ToolKnox/Quadruped-II/BOM.pdf

B I L L O F M A T E R I A L S

# Quadruped II

Rev. 2026-04-30 96 items

View this project on Printables (https://www.printables.com/model/1451339-quadruped-ii) | Buy me a Beer (https://www.paypal.com/paypalme/TomKnox3d) | Join my club for exclusive models (https://www.printables.com/@TomKnox_1573)

BOM | Product/Project: Quadruped II
Revision date: 2026-04-30 | https://www.printables.com/model/1451339-quadruped-ii
ELECTRICAL COMPONENTS | 22 items
Description | Qty | AliExpress | Amazon (Geniuslink) | Notes

>>

0001-1202 Power_Dist-PCB | 1

SPECIAL CTA

Order PCB HERE (https://www.pcbway.com/project/shareproject/Quadruped_PCB_v1_0_3a5d3450.html)

Power Distrivbution PCB - PCB Files availible for Clubmembers

>>

Servo Motors | x12 | AliExpress Link (https://s.click.aliexpress.com/e/_c3oYCwzH) | Amazon Link (https://geni.us/niJrcJn)

180 degrees, 35kg (Approx
49.5x20,2x40mm)

->

ALT | Servo Motors | x12 | AliExpress Link (https://s.click.aliexpress.com/e/_c355UoGD) | Amazon Link (https://geni.us/RV1IBB) | Budget friendly alternative.

->

ALT | Servo Motors | x12 | AliExpress Link (https://s.click.aliexpress.com/e/_c4nKdy0D) | Amazon Link (https://geni.us/aHJvHX3) | Budget friendly alternative.
>> | Raspberry Pi 4 Model B | 1 | AliExpress Link (https://s.click.aliexpress.com/e/_c3vHe6u7) | Amazon Link (https://geni.us/j51XYY) | 8gb Ram

>>

LiPo Battery | 1 | AliExpress Link (https://s.click.aliexpress.com/e/_c3RFa1Cf) | Amazon Link (https://geni.us/4H2lJ)

4000mAh 4S 45~90C Lipo Pack w/XT-90

>> | IMU | 1 | AliExpress Link (https://s.click.aliexpress.com/e/_c3RY5ql9) | Amazon Link (https://geni.us/GV5tKTw) | Integrated Measuring Unit
>> | Raspberry Pi Breakout Board | 1 | AliExpress Link (https://s.click.aliexpress.com/e/_c3qH7iyL) | Amazon Link (https://geni.us/MbTbrQP) | Made by Dfrobot
>> | Fan | x2 | AliExpress Link (https://s.click.aliexpress.com/e/_c2yKau2J) | Amazon Link (https://geni.us/bTXZ0) | 60x60 12v
>> | Servo Driver PCA9685 | 1 | AliExpress Link (https://s.click.aliexpress.com/e/_c4WSVNR5) | Amazon Link (https://geni.us/AAHBTxq) | Communication via I2C interface

>>

Arduino Nano | 1 | AliExpress Link (https://s.click.aliexpress.com/e/_c4lOubMf) | Amazon Link (https://geni.us/aKQfQgw)

For IMU, Battery sensing, LCD screen

>> | DC to DC (Buck) converter 20A | 1 | AliExpress Link (https://s.click.aliexpress.com/e/_c4a1nZOH) | Amazon Link (https://geni.us/TxDhP) | Adjustable, set to ~7V
>> | DC to DC (buck) converter 3A | 1 | AliExpress Link (https://s.click.aliexpress.com/e/_c3nZjuCN) | Amazon Link (https://geni.us/S4EAS28) | For fans
>> | 32GB MicroSD card | 1 | AliExpress Link (https://s.click.aliexpress.com/e/_c4Vsk2D9) | Amazon Link (https://geni.us/dKVzS49) | 32GB is maximum Pi supports
>> | RasbPi Cooling System | 1 | AliExpress Link (https://s.click.aliexpress.com/e/_c4VTyh0n) | Amazon Link (https://geni.us/PANnd) | -
>> | Arduino Nano Breakout Board | 1 | AliExpress Link (https://s.click.aliexpress.com/e/_c4dG8Y8L) | Amazon Link (https://geni.us/PcfeRm2) | -

BOM | Product/Project: Quadruped II
Revision date: 2026-04-30 | https://www.printables.com/model/1451339-quadruped-ii

### ELECTRICAL COMPONENTS continued

Description | Qty | AliExpress | Amazon (Geniuslink) | Notes

>>

GPIO Cable | 1 | AliExpress Link (https://s.click.aliexpress.com/e/_c4avRRfl) | Amazon Link (https://geni.us/EjrSRtX) | To connect Pi to its breakout board

>>

| Logic Level Converter | 1 | AliExpress Link (https://s.click.aliexpress.com/e/_c2wzgmJt) | Amazon Link (https://geni.us/3TiJfB) | For adjusting voltage between the pi and the nano
>> | XT60H Connector | 1 | AliExpress Link (https://s.click.aliexpress.com/e/_c3piOj51) | Amazon Link (https://geni.us/aVZdcGf) | To connect LiPo to the robot
>> | LCD Screen | 1 | AliExpress Link (https://s.click.aliexpress.com/e/_c4pjNsUD) | Amazon Link (https://geni.us/CAwIn) | 1.47 inch
>> | PS4 Controller | 1 | AliExpress Link (https://s.click.aliexpress.com/e/_c4CvwWxp) | Amazon Link (https://geni.us/XiW4) | -
>> | Digital Voltmeter | 1 | AliExpress Link (https://s.click.aliexpress.com/e/_c3UuRXlD) | Amazon Link (https://geni.us/mbArXwk) | DC 2.5-30V, used to measure battery voltage

BOM | Product/Project: Quadruped II
Revision date: 2026-04-30 | https://www.printables.com/model/1451339-quadruped-ii
MECHANICAL COMPONENTS | 28 items
| Description | Qty | AliExpress | Amazon (Geniuslink) | Notes
>> | Bearing | x4 | AliExpress Link (https://s.click.aliexpress.com/e/_c4qqMrGR) | Amazon Link (https://geni.us/AmOzp) | 6705-2RS 25X32X4
>> | Thrust Bearings | x4 | AliExpress Link (https://s.click.aliexpress.com/e/_c4LuEC4L) | Amazon Link (https://geni.us/sMGxk4) | F4-10M 4x10x4mm
>> | Bearing | x20 | AliExpress Link (https://s.click.aliexpress.com/e/_c4lVCOIX) | Amazon Link (https://geni.us/zvnXU) | 684ZZ Mini Deep Groove Ball Bearing 4x9x4mm
>> | Servo horns | x4 | AliExpress Link (https://s.click.aliexpress.com/e/_c3qWmlYf) | Amazon Link (https://geni.us/KN5c9Mg) | RC Car Steering Servo Horn Arm 25T Teeth Long
>> | Heatsinks | x12 | AliExpress Link (https://s.click.aliexpress.com/e/_c3aKP3CR) | Amazon Link (https://geni.us/lxJBOw) | 6mm, black. Cut in half for each servo
>> | Servo Discs | x10 | AliExpress Link (https://s.click.aliexpress.com/e/_c3ajtifh) | Amazon Link (https://geni.us/ZDgXW) | with screws.
>> | Threaded rods - Long | x4 | AliExpress Link (https://s.click.aliexpress.com/e/_c4UsQtab) | Amazon Link (https://geni.us/M8sIZIp) | M3 x 110mm (cut to length if needed)
>> | Threaded rods - Short | x4 | AliExpress Link (https://s.click.aliexpress.com/e/_c4ohc7TN) | Amazon Link (https://geni.us/IXWZiC0) | M3 x 25mm (cut to length if needed)
>> | Magnets | x8 | AliExpress Link (https://s.click.aliexpress.com/e/_c4PVNdwL) | Amazon Link (https://geni.us/OPu9pBg) | Used to hold fans in place
>> | Ballt Joint (Long joint) | x8 | AliExpress Link (https://s.click.aliexpress.com/e/_c4BWGoqR) | Amazon Link (https://geni.us/DR5Z7v) | S - 3mm L30mm M3
>> | Ball Join (Short Joint) | x8 | AliExpress Link (https://s.click.aliexpress.com/e/_c4BWGoqR) | Amazon Link (https://geni.us/BkDvnH) | N - 3mm L20mm M3
>> | On/off Switch | 1 | AliExpress Link (https://s.click.aliexpress.com/e/_c2x5Xvx9) | Amazon Link (https://geni.us/dgsSxN) | 20A at 14VDC rated
>> | Spring | 1 | AliExpress Link (https://s.click.aliexpress.com/e/_c38DYmvz) | Amazon Link (https://geni.us/t9JlB) | For battery latch mechanism. 35mm long x 7mm OD
>> | Smooth Rod 3x80 | 1 | AliExpress Link (https://s.click.aliexpress.com/e/_c3QIiv61) | Amazon Link (https://geni.us/6dBY98) | For battery hinge mechanism 3x75-80mm (cut to length if needed)
>> | Misc | 1 | - | - | -

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

### MECHANICAL COMPONENTS continued

| Description | Qty | AliExpress | Amazon (Geniuslink) | Notes
>> | Male Connector (for peripherals) | x12 | AliExpress Link (https://s.click.aliexpress.com/e/_c3eOJxcB) | Amazon Link (https://geni.us/g3jfpk7) | B2B-PH-K-S(LF)(SN)
>> | Socket for Connectors | x25 | AliExpress Link (https://s.click.aliexpress.com/e/_c4XMd4bp) | Amazon Link (https://geni.us/FWRkK) | SPH-002T-P0.5S
>> | Female Connector (for peripherals) | x12 | AliExpress Link (https://s.click.aliexpress.com/e/_c3AkcVdD) | Amazon Link (https://geni.us/Auyl1wR) | PHR-2
>> | Capacitor | 1 | AliExpress Link (https://s.click.aliexpress.com/e/_c4N6hXdZ) | Amazon Link (https://geni.us/Hxr7KrE) | 2200uF 16VDC Electrolytic RB Capacitor ,For servo board
>> | Reverse Polarity Protection Diode | 1 | AliExpress Link (https://s.click.aliexpress.com/e/_c3GnIKbp) | Amazon Link (https://geni.us/2JNVK) | B160-13-F
>> | Ferrules | 1 | AliExpress Link (https://s.click.aliexpress.com/e/_c4b0JD7N) | Amazon Link (https://geni.us/uW3lDP) | Optional, if used need approx 20 across robot
>> | Terminal Blocks | x8 | AliExpress Link (https://s.click.aliexpress.com/e/_c4pZ8KUj) | Amazon Link (https://geni.us/jVKo7C) | 1935776
>> | 100k resistors | 1 | AliExpress Link (https://s.click.aliexpress.com/e/_c3fDqW83) | Amazon Link (https://geni.us/CDzFOW) | For dividing the voltage at the buck converter so that it is readable by the nano
>> | 47k Resistor | 1 | AliExpress Link (https://s.click.aliexpress.com/e/_c4c1Cx8n) | Amazon Link (https://geni.us/wGvVe) | CRGCQ1206F47K
>> | 10k resistor | 1 | AliExpress Link (https://s.click.aliexpress.com/e/_c4c1Cx8n) | Amazon Link (https://geni.us/aShan4) | CRGCQ0805F10K
>> | Heat Shrink | 1 | AliExpress Link (https://s.click.aliexpress.com/e/_c30Kx0Xt) | Amazon Link (https://geni.us/QeW8) | Only small amount required, for covering exposed solid-core wires
>> | Power Delivery Wire | 1 | AliExpress Link (https://s.click.aliexpress.com/e/_c3XeHXW7) | Amazon Link (https://geni.us/XebB) | Minimum 12AWG, for wires expected to carry current above 2A and/or voltage above 5V
>> | Connection Wire | 1 | AliExpress Link (https://s.click.aliexpress.com/e/_c3XeHXW7) | Amazon Link (https://geni.us/BbErE) | 19-30AWG, recommend solid core, used for all other wires

BOM | Product/Project: Quadruped II
Revision date: 2026-04-30 | https://www.printables.com/model/1451339-quadruped-ii
FASTENERS | 22 items
| Description | Qty | AliExpress | Amazon (Geniuslink) | Notes
>> | MC6S-M2x8 | x8 | AliExpress Link (https://s.click.aliexpress.com/e/_c4bQkDH7) | Amazon Link (https://geni.us/rs8P) | M2 - Socket Head Cap Screw
>> | M6CS-M2x4 | x14 | AliExpress Link (https://s.click.aliexpress.com/e/_c4bQkDH7) | Amazon Link (https://geni.us/rs8P) | M2 - Socket Head Cap Screw
>> | MC6S-M2.5x6 | x8 | AliExpress Link (https://s.click.aliexpress.com/e/_c4bQkDH7) | Amazon Link (https://geni.us/Dwz2G) | M2.5 - Socket Head Cap Screw
>> | MC6S-M3x8H | x38 | AliExpress Link (https://s.click.aliexpress.com/e/_c4bQkDH7) | Amazon Link (https://geni.us/opo4e) | M3 - Socket Head Cap Screw
>> | MC6S-M3x10H | x4 | AliExpress Link (https://s.click.aliexpress.com/e/_c4bQkDH7) | Amazon Link (https://geni.us/BrqdjZP) | M3 - Socket Head Cap Screw
>> | MC6S-M3x14H | x6 | AliExpress Link (https://s.click.aliexpress.com/e/_c4bQkDH7) | Amazon Link (https://geni.us/pltePAU) | M3 - Socket Head Cap Screw
>> | MC6S-M3x20H | x16 | AliExpress Link (https://s.click.aliexpress.com/e/_c4bQkDH7) | Amazon Link (https://geni.us/9za99) | M3 - Socket Head Cap Screw
>> | MC6S-M3x25 | x4 | AliExpress Link (https://s.click.aliexpress.com/e/_c4bQkDH7) | Amazon Link (https://geni.us/W5BJX) | M3 - Socket Head Cap Screw
>> | MC6S-M4x25H | x4 | AliExpress Link (https://s.click.aliexpress.com/e/_c4bQkDH7) | Amazon Link (https://geni.us/rjvj) | M4 - Socket Head Cap Screw
>> | MC6S-M4x16H | x4 | AliExpress Link (https://s.click.aliexpress.com/e/_c4bQkDH7) | Amazon Link (https://geni.us/wGOaQNE) | M4 - Socket Head Cap Screw
>> | MF6S-M3x8 | x52 | AliExpress Link (https://s.click.aliexpress.com/e/_c3LeLqlR) | Amazon Link (https://geni.us/5EC13) | M3 - Countersunk Socket Head Cap Screw
>> | K6S - M3x8 | x4 | AliExpress Link (https://s.click.aliexpress.com/e/_c3uHOBwN) | Amazon Link (https://geni.us/Ggr2) | M3 - Socket Button Head Screw
>> | K6S - M3x10 | x10 | AliExpress Link (https://s.click.aliexpress.com/e/_c3uHOBwN) | Amazon Link (https://geni.us/Tn9Jbag) | M3 - Socket Button Head Screw
>> | K6S - M3x16 | x36 | AliExpress Link (https://s.click.aliexpress.com/e/_c3uHOBwN) | Amazon Link (https://geni.us/NH5M) | M3 - Socket Button Head Screw
>> | K6S - M3x20 | x20 | AliExpress Link (https://s.click.aliexpress.com/e/_c3uHOBwN) | Amazon Link (https://geni.us/h6GNo) | M3 - Socket Button Head Screw
>> | RBS M3 (3,2x9x0,8)) | x4 | AliExpress Link (https://s.click.aliexpress.com/e/_c3ctsHrn) | Amazon Link (https://geni.us/OP2NLH7) | M3 Washer with Large O.D
>> | LM6M_A4-70(M3) | x24 | AliExpress Link (https://s.click.aliexpress.com/e/_c3CqMkJb) | Amazon Link (https://geni.us/igAkxP) | M3 Lock Nut
>> | ML6M M3 Nut | x8 | AliExpress Link (https://s.click.aliexpress.com/e/_c2wZar4p) | Amazon Link (https://geni.us/jg3ct) | M3 Nut - Low profile

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

### FASTENERS continued

| Description | Qty | AliExpress | Amazon (Geniuslink) | Notes
>> | Heat insert M3 3x5 | x96 | AliExpress Link (https://s.click.aliexpress.com/e/_c3VnredP) | Amazon Link (https://geni.us/5CT5Hf) | L=3 O.D=5
>> | Heat Insert M2 3x3 | x18 | AliExpress Link (https://s.click.aliexpress.com/e/_c3VnredP) | Amazon Link (https://geni.us/odta) | L=3 O.D=3
>> | Heat Insert M2.5 3x3.5 | x8 | AliExpress Link (https://s.click.aliexpress.com/e/_c3VnredP) | Amazon Link (https://geni.us/AATZv) | L=3 O.D=3
>> | Heat Insert M4 4x6 | x8 | AliExpress Link (https://s.click.aliexpress.com/e/_c3VnredP) | Amazon Link (https://geni.us/Naao9e) | L=4 O.D=6

BOM | Product/Project: Quadruped II
Revision date: 2026-04-30 | https://www.printables.com/model/1451339-quadruped-ii
ASSORTMENT BOXES | 7 items
| Description | Qty | AliExpress | Amazon (Geniuslink) | Notes
>> | Socket Button Head Screw | 1 | AliExpress Link (https://s.click.aliexpress.com/e/_c3s2tYkH) | Amazon Link (https://geni.us/V4MKIHK) | M2-M3 x 2510pcs
>> | Socket head cap Screw | 1 | AliExpress Link (https://s.click.aliexpress.com/e/_c4CtzBjJ) | Amazon Link (https://geni.us/cEH1f) | 2500pcs M2M2.5M3
>> | Socket head cap Screw | 1 | AliExpress Link (https://s.click.aliexpress.com/e/_c4CtzBjJ) | Amazon Link (https://geni.us/XJ9Pwm) | 1410pcs M3M4M5
>> | Countersunk Socket Head Cap Screw | 1 | AliExpress Link (https://s.click.aliexpress.com/e/_c4dPOZ2H) | Amazon Link (https://geni.us/cZwP7Io) | 3045pcs - M2, M3, M4, M5, M6, M8
>> | Heat Insert (with press) | 1 | AliExpress Link (https://s.click.aliexpress.com/e/_c4VcldtL) | Amazon Link (https://geni.us/pHv01s) | 1040pcs - M2-M4
>> | Heat Inserts | 1 | AliExpress Link (https://s.click.aliexpress.com/e/_c3cIZWyz) | Amazon Link (https://geni.us/yffvAR) | 1400pcs - M2-M4
>> | Lock Nut | 1 | AliExpress Link (https://s.click.aliexpress.com/e/_c2xGmpNx) | Amazon Link (https://geni.us/ZU2w) | 230pcs M3,M4,M5,M6,M8

BOM | Product/Project: Quadruped II
Revision date: 2026-04-30 | https://www.printables.com/model/1451339-quadruped-ii
FILAMENT | 4 items
| Description | Qty | AliExpress | Amazon (Geniuslink) | Notes
>> | PC / ASA / ABS / PETG Filament | 1 | AliExpress Link (https://s.click.aliexpress.com/e/_c3TLvFW9) | Amazon Link (https://geni.us/enf7pY) | -
>> | PC-CF / PETG-CF / PA-CF / ABS+ (Engineering Grade
| Filaments) | 1 | AliExpress Link (https://s.click.aliexpress.com/e/_c3sc5Ef3) | Amazon Link (https://geni.us/khjmN) | -
>> | PLA | 1 | AliExpress Link (https://s.click.aliexpress.com/e/_c3lakGcl) | Amazon Link (https://geni.us/pBQCzkI) | -
>> | TPU | 1 | AliExpress Link (https://s.click.aliexpress.com/e/_c4mEXgLb) | Amazon Link (https://geni.us/NGlAPc) | -

BOM | Product/Project: Quadruped II
Revision date: 2026-04-30 | https://www.printables.com/model/1451339-quadruped-ii
TOOLS | 13 items
Description | Qty | AliExpress | Amazon (Geniuslink) | Notes
>> | Soldering Iron TS101 | 1 | AliExpress Link (https://s.click.aliexpress.com/e/_c2QmV6QP) | Amazon Link (https://geni.us/rPNNHLD) | (Recommended)
>> | Heat Inset Tip Kit - For TS101 | 1 | AliExpress Link (https://s.click.aliexpress.com/e/_c4oAQMU5) | Amazon Link (https://geni.us/hrT4m82) | (Recommended)
>> | Electric Precision Screwdriver | 1 | AliExpress Link (https://s.click.aliexpress.com/e/_c4WbOjBf) | Amazon Link (https://geni.us/ckKSnm) | (Recommended)
>> | Allen Key Set | 1 | AliExpress Link (https://s.click.aliexpress.com/e/_c4dcwKsN) | Amazon Link (https://geni.us/DTXl) | (Recommended)
>> | Torx Key Set | 1 | AliExpress Link (https://s.click.aliexpress.com/e/_c3zbLorL) | Amazon Link (https://geni.us/35Em2C) | (Recommended)
>> | Torque Screwdriver | 1 | AliExpress Link (https://s.click.aliexpress.com/e/_c39Zxrt7) | Amazon Link (https://geni.us/ckKSnm) | (Recommended)
>> | Wire stripper | 1 | AliExpress Link (https://s.click.aliexpress.com/e/_c3fd1zBB?SearchText=Wire+stripper) | Amazon Link (https://geni.us/SvNtLpP) | (Recommended)
>> | Wire cutter | 1 | AliExpress Link (https://s.click.aliexpress.com/e/_c2yogYf1) | Amazon Link (https://geni.us/TFzOR4) | (Recommended)
>> | Heat Insert Press Tool | 1 | AliExpress Link (https://s.click.aliexpress.com/e/_c3ljOLkX) | Amazon Link (https://geni.us/g0yu0) | (Recommended)
>> | Crimp Tool | 1 | AliExpress Link (https://s.click.aliexpress.com/e/_c4VtpJeL) | Amazon Link (https://geni.us/RH6Ac9) | (Recommended)

->

ALT | Soldering Iron - Generic | 1 | AliExpress Link (https://s.click.aliexpress.com/e/_c4sOxkox) | Amazon Link (https://geni.us/Drzhe7o) | Budget friendly alternative

->

ALT | Heat insert tip - set | 1 | AliExpress Link (https://s.click.aliexpress.com/e/_c4V88eu7) | Amazon Link (https://geni.us/aAqQH) | Budget friendly alternative
>> | Precision Screwdriver Set | 1 | AliExpress Link (https://s.click.aliexpress.com/e/_c3bHpwH9) | Amazon Link (https://geni.us/Kk4tgSV) | Budget friendly alternative
