ToolKnox/Quadruped-II/Quadruped_ws/src/Quadruped_description/meshes/R2_obj.obj

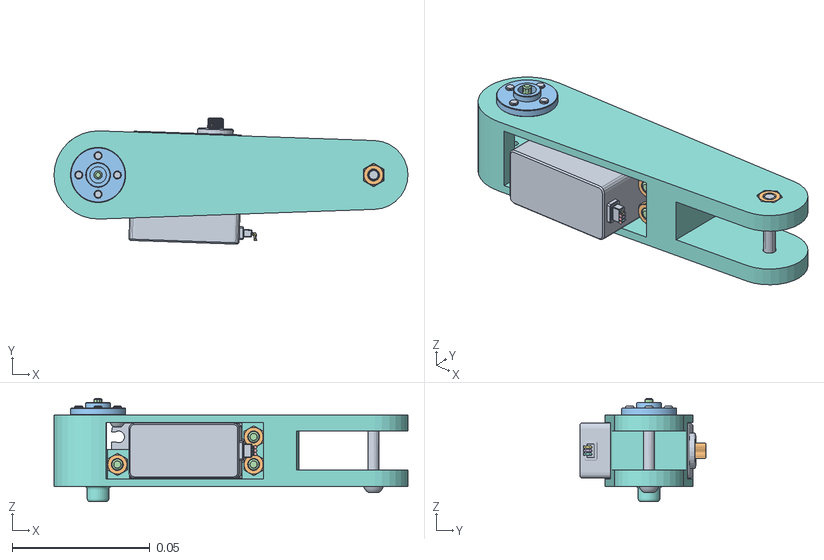
[picture p2: CAD file, 2026-04-30]
Quadruped_ws/src/Quadruped_description/meshes/R2_obj.obj
0.129 x 0.0459 x 0.0375
mesh 1 R2 joint-1/CLS6336HV-1
mesh 2 Boss-Extrude5
mesh 3 Boss-Extrude4
mesh 4 Boss-Extrude7
mesh 5 Boss-Extrude1
mesh 6 Boss-Extrude2
mesh 7 Cut-Extrude1
mesh 8 Boss-Extrude3
mesh 9 Sweep1 face
mesh 10 Fillet1
mesh 11 Fillet2
mesh 12 Chamfer1
