ToolKnox/Quadruped-II/Quadruped_ws/src/Quadruped_description/meshes/RL_link3.STL

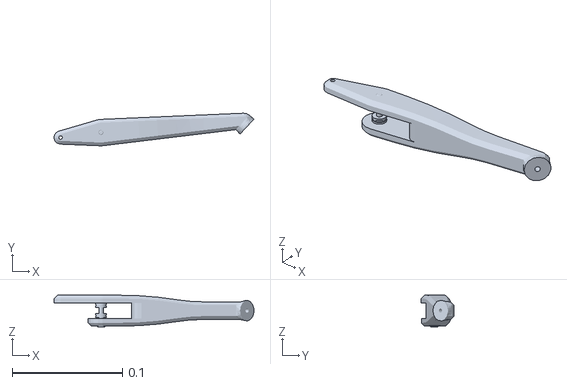
[picture p3: CAD file, 2026-04-30]
Quadruped_ws/src/Quadruped_description/meshes/RL_link3.STL
0.181 x 0.0296 x 0.029
