ToolKnox/Quadruped-II/Quadruped_ws/src/Quadruped_description/meshes/FR_link4.STL

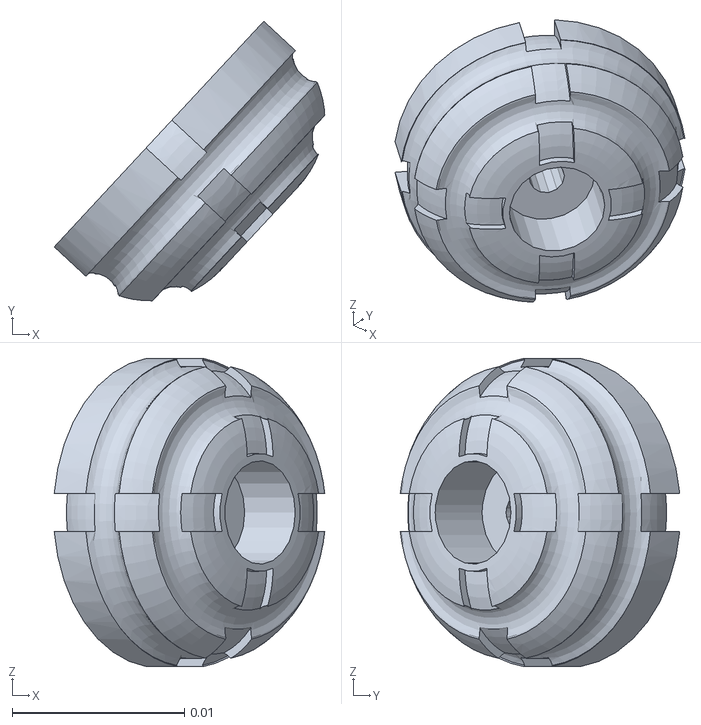
[picture p4: CAD file, 2026-04-30]
Quadruped_ws/src/Quadruped_description/meshes/FR_link4.STL
0.0157 x 0.0162 x 0.0179
