ToolKnox/Quadruped-II/Quadruped_ws/src/Quadruped_description/meshes/R_link2_collision.STL

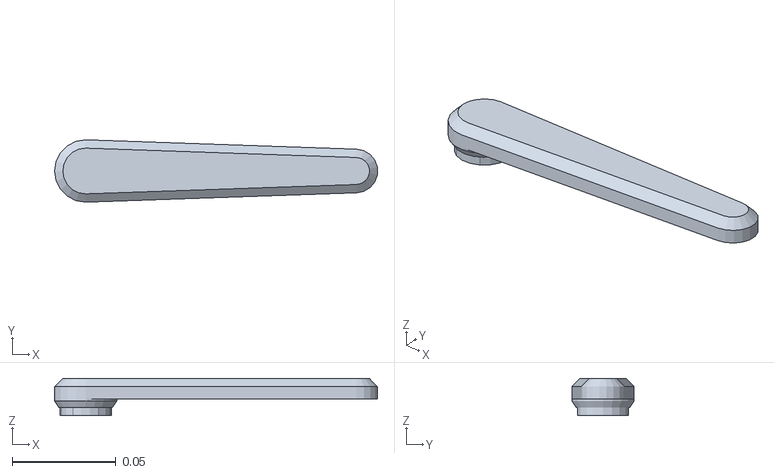
[picture p5: CAD file, 2026-04-30]
Quadruped_ws/src/Quadruped_description/meshes/R_link2_collision.STL
0.155 x 0.03 x 0.018
