ToolKnox/Quadruped-II/Quadruped_ws/src/Quadruped_description/meshes/FL_link2.STL

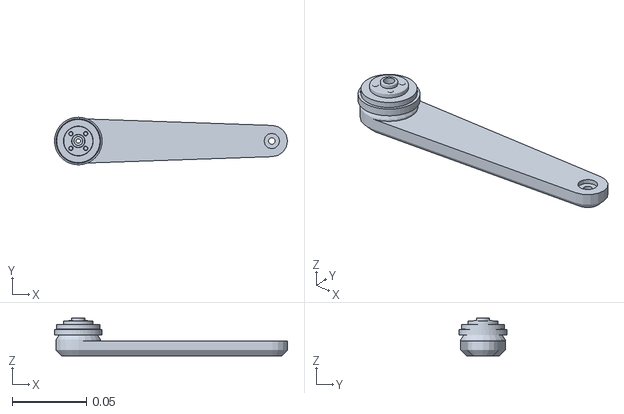
[picture p6: CAD file, 2026-04-30]
Quadruped_ws/src/Quadruped_description/meshes/FL_link2.STL
0.156 x 0.032 x 0.0255
