ToolKnox/Quadruped-II/Quadruped_ws/src/Quadruped_description/meshes/RR1_obj.obj

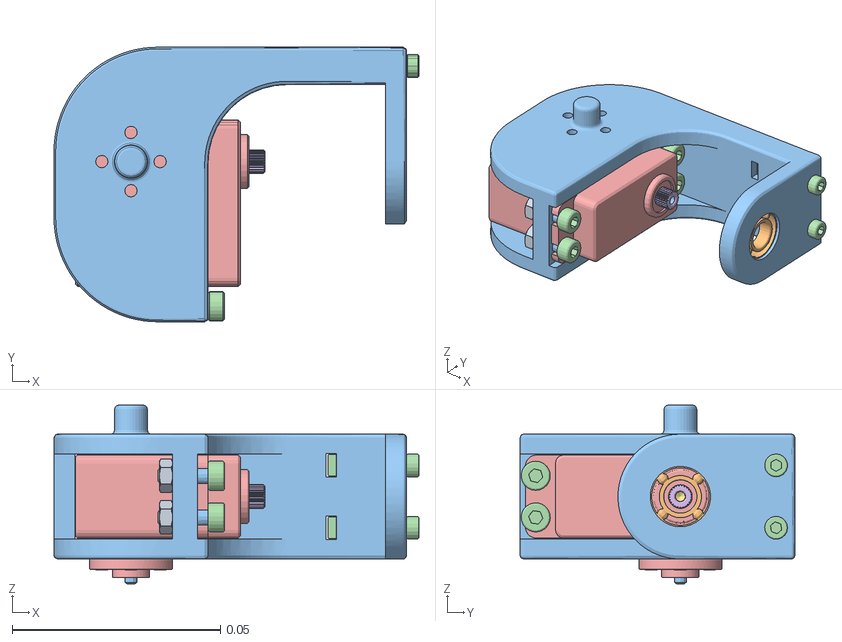
[picture p7: CAD file, 2026-04-30]
Quadruped_ws/src/Quadruped_description/meshes/RR1_obj.obj
0.0877 x 0.066 x 0.043
mesh 1 RR1 joint-1/M4 Nut DIN 934-2
mesh 2 RR1 joint-1/M4 Nut DIN 934-6
mesh 3 RR1 joint-1/688 CN-1/bearing_688_1_01-1
mesh 4 RR1 joint-1/688 CN-1/bearing_688_1_02-1
mesh 5 RR1 joint-1/688 CN-1/bearing_688_1_03-1
mesh 6 RR1 joint-1/M4 Nut DIN 934-1
mesh 7 RR1 joint-1/M3 x 6 DIN 912-1
mesh 8 Chamfer1 face
mesh 9 RR1 joint-1/CLS6336HV-1
mesh 10 Boss-Extrude5
mesh 11 Boss-Extrude4
mesh 12 Boss-Extrude7
mesh 13 Boss-Extrude1
mesh 14 Boss-Extrude2
