ToolKnox/Quadruped-II/Quadruped_ws/src/Quadruped_description/meshes/RR_link1.STL

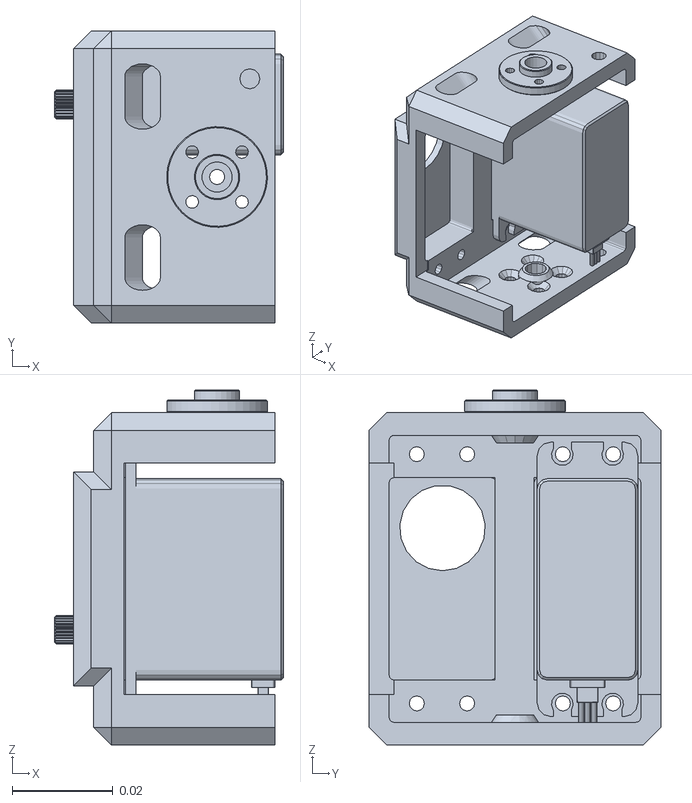
[picture p8: CAD file, 2026-04-30]
Quadruped_ws/src/Quadruped_description/meshes/RR_link1.STL
0.0455 x 0.058 x 0.0705
