ToolKnox/Quadruped-II/Quadruped_ws/src/Quadruped_description/meshes/hokuyo_ust10.stl

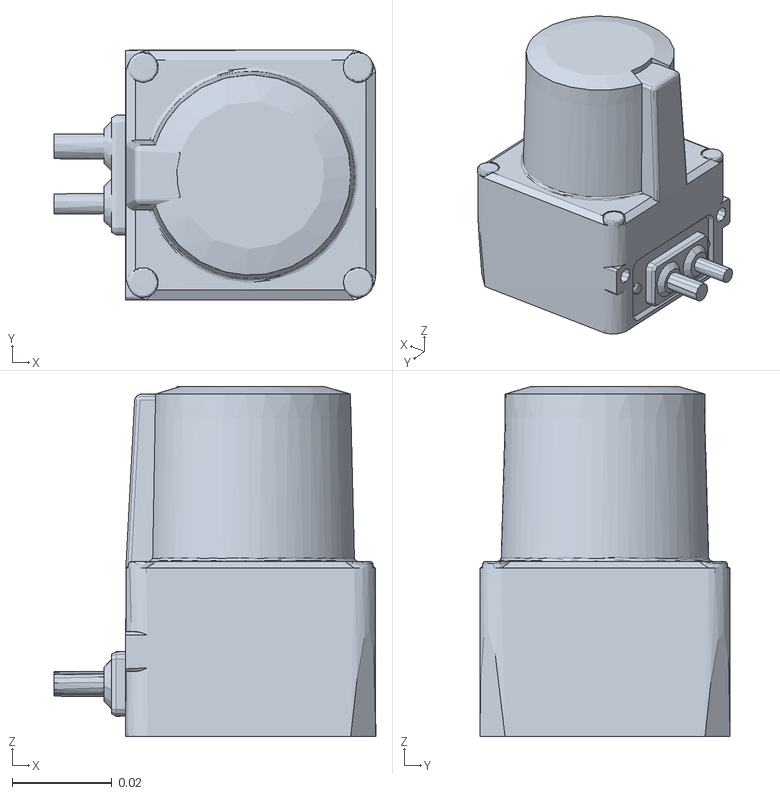
[picture p9: CAD file, 2026-04-30]
Quadruped_ws/src/Quadruped_description/meshes/hokuyo_ust10.stl
0.0643 x 0.05 x 0.07
