ToolKnox/Quadruped-II/Quadruped_ws/src/Quadruped_description/meshes/R3_obj.obj

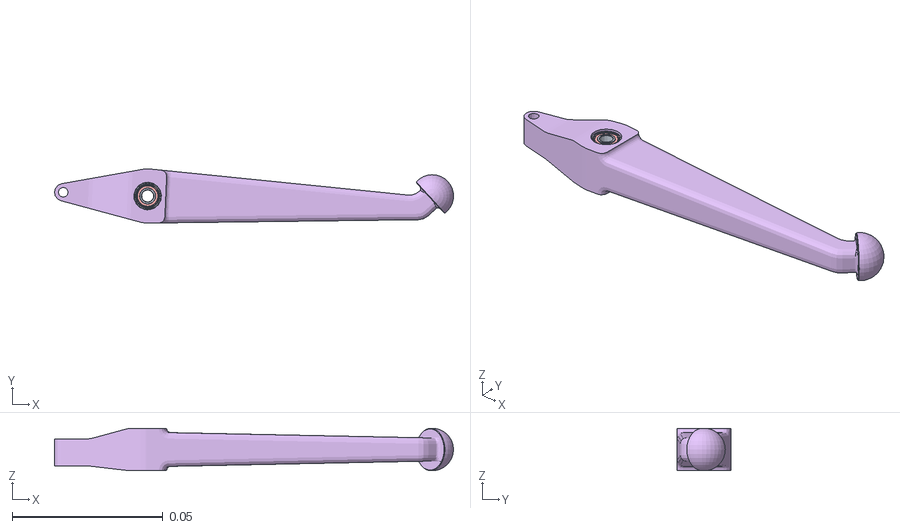
[picture p10: CAD file, 2026-04-30]
Quadruped_ws/src/Quadruped_description/meshes/R3_obj.obj
0.132 x 0.018 x 0.014
mesh 1 R 3 joint-1/684 2Z CN-1
mesh 2 Imported_11-1-solid1 face
mesh 3 Imported_11-1-solid1
mesh 4 Imported_9-1-solid1 face
mesh 5 Imported_1-1-solid1 face
mesh 6 Imported_4-1-solid1 face
