ToolKnox/Quadruped-II/Quadruped_ws/src/Quadruped_description/meshes/base_collision.STL

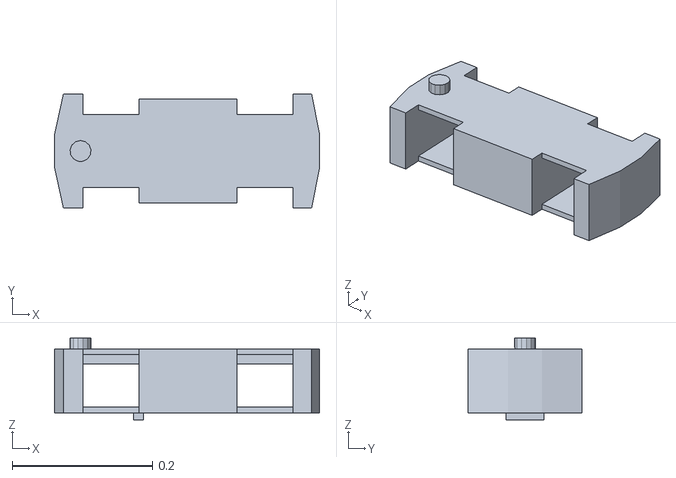
[picture p11: CAD file, 2026-04-30]
Quadruped_ws/src/Quadruped_description/meshes/base_collision.STL
0.378 x 0.162 x 0.117
