ToolKnox/Quadruped-II/Quadruped_ws/src/Quadruped_description/meshes/L_link1_collision.STL

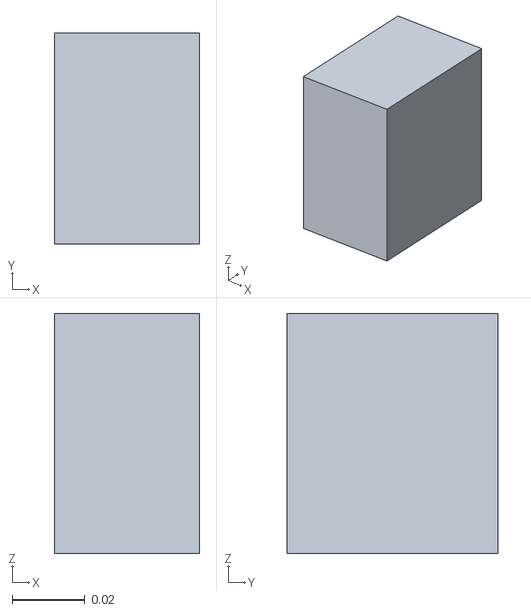
[picture p12: CAD file, 2026-04-30]
Quadruped_ws/src/Quadruped_description/meshes/L_link1_collision.STL
0.04 x 0.058 x 0.066
