ToolKnox/Quadruped-II/Quadruped_ws/src/Quadruped_description/meshes/VLP16_base_2.stl

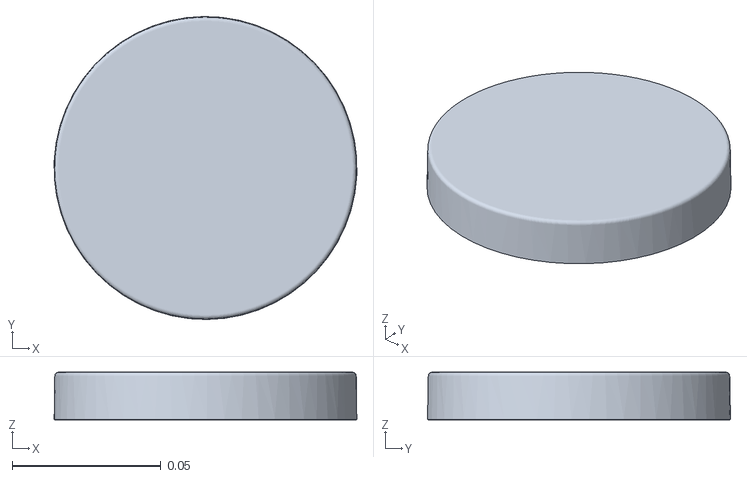
[picture p13: CAD file, 2026-04-30]
Quadruped_ws/src/Quadruped_description/meshes/VLP16_base_2.stl
0.102 x 0.102 x 0.016
