ToolKnox/Quadruped-II/Quadruped_ws/src/Quadruped_description/meshes/L_link3_collision.STL

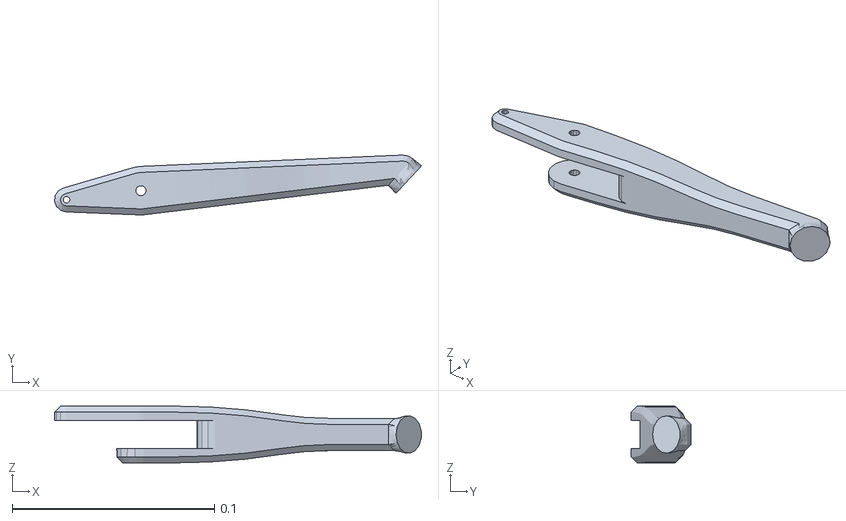
[picture p14: CAD file, 2026-04-30]
Quadruped_ws/src/Quadruped_description/meshes/L_link3_collision.STL
0.181 x 0.0296 x 0.028
