ToolKnox/Quadruped-II/Quadruped_ws/src/Quadruped_description/meshes/VLP16_base_1.stl

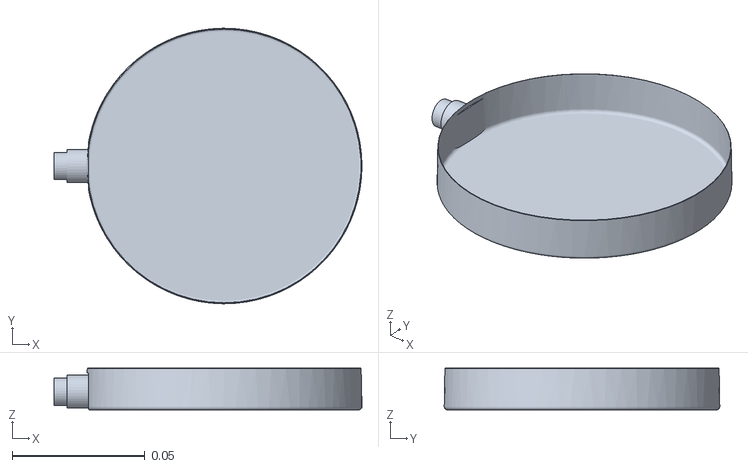
[picture p15: CAD file, 2026-04-30]
Quadruped_ws/src/Quadruped_description/meshes/VLP16_base_1.stl
0.116 x 0.104 x 0.0157
