ToolKnox/Quadruped-II/Quadruped_ws/src/Quadruped_description/meshes/link4_collision.STL

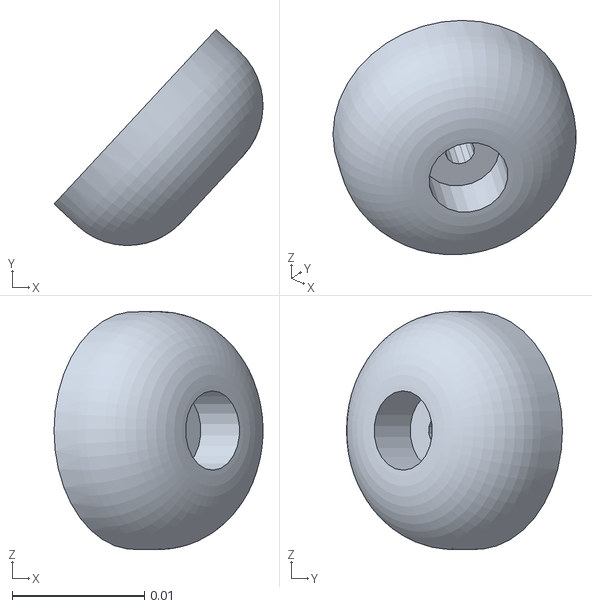
[picture p16: CAD file, 2026-04-30]
Quadruped_ws/src/Quadruped_description/meshes/link4_collision.STL
0.0158 x 0.0163 x 0.018
