ToolKnox/Quadruped-II/Quadruped_ws/src/Quadruped_description/meshes/VLP16_scan.stl

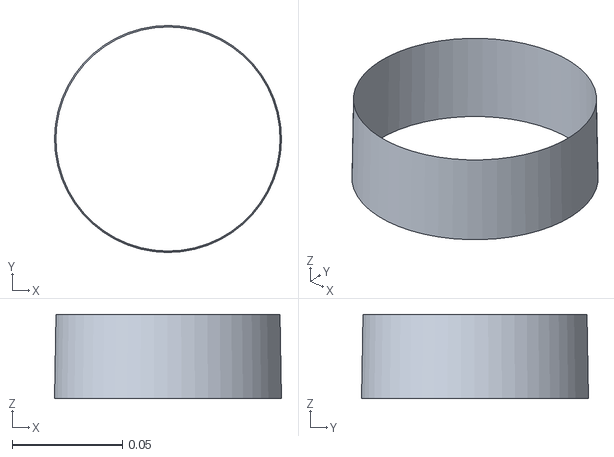
[picture p17: CAD file, 2026-04-30]
Quadruped_ws/src/Quadruped_description/meshes/VLP16_scan.stl
0.103 x 0.103 x 0.0381
