ToolKnox/Quadruped-II/Quadruped_ws/src/Quadruped_description/meshes/base_link.STL

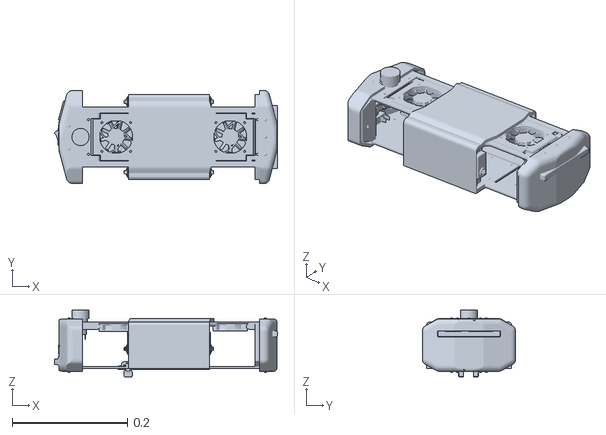
[picture p18: CAD file, 2026-04-30]
Quadruped_ws/src/Quadruped_description/meshes/base_link.STL
0.387 x 0.162 x 0.116
