ToolKnox/Quadruped-II/(list of files, cad)

Other CAD files:
Quadruped_ws/src/Quadruped_description/meshes/L2_obj.obj
Quadruped_ws/src/Quadruped_description/meshes/FL_link4.STL
Quadruped_ws/src/Quadruped_description/meshes/FR1_obj.obj
Quadruped_ws/src/Quadruped_description/meshes/FL1_obj.obj
Quadruped_ws/src/Quadruped_description/meshes/FL_link3.STL
Quadruped_ws/src/Quadruped_description/meshes/RL_link4.STL
Quadruped_ws/src/Quadruped_description/meshes/RL1_obj.obj
Quadruped_ws/src/Quadruped_description/meshes/RR_link3.STL
Quadruped_ws/src/Quadruped_description/meshes/FR_link1.STL
Quadruped_ws/src/Quadruped_description/meshes/RL_link2.STL
Quadruped_ws/src/Quadruped_description/meshes/FR_link2.STL
Quadruped_ws/src/Quadruped_description/meshes/FR_link3.STL
Quadruped_ws/src/Quadruped_description/meshes/RR_link4.STL
Quadruped_ws/src/Quadruped_description/meshes/R_link3_collision.STL
Quadruped_ws/src/Quadruped_description/meshes/RL_link1.STL
Quadruped_ws/src/Quadruped_description/meshes/L_link2_collision.STL
Quadruped_ws/src/Quadruped_description/meshes/FL_link1.STL
Quadruped_ws/src/Quadruped_description/meshes/L3_obj.obj
Quadruped_ws/src/Quadruped_description/meshes/RR_link2.STL
Quadruped_ws/src/Quadruped_description/meshes/R_link1_collision.STL
