ToolKnox/Quadruped-II/Quadruped_ws/src/Quadruped_gazebo/config/controllers.yaml

quadruped_controller:
  
  joint_states_controller:
      type: joint_state_controller/JointStateController
      publish_rate: 25

  # FL Controllers ------------------------------------------------------------ 
  FL_theta1:
      type: effort_controllers/JointPositionController
      joint: FL_theta1
      pid: {p: 9, i: 0.03, d: 0.3055, i_clamp_min:  -1000, i_clamp_max: 1000}
        
  FL_theta2:
      type: effort_controllers/JointPositionController
      joint: FL_theta2
      pid: {p: 9, i: 0.03, d: 0.3055, i_clamp_min:  -1000, i_clamp_max: 1000}
        
  FL_theta3:
      type: effort_controllers/JointPositionController
      joint: FL_theta3
      pid: {p: 9, i: 0.03, d: 0.3055, i_clamp_min:  -1000, i_clamp_max: 1000}

  # FR Controllers ------------------------------------------------------------ 
  FR_theta1:
      type: effort_controllers/JointPositionController
      joint: FR_theta1
      pid: {p: 9, i: 0.03, d: 0.3055, i_clamp_min:  -1000, i_clamp_max: 1000}
        
  FR_theta2:
      type: effort_controllers/JointPositionController
      joint: FR_theta2
      pid: {p: 9, i: 0.03, d: 0.3055, i_clamp_min:  -1000, i_clamp_max: 1000}
        
  FR_theta3:
      type: effort_controllers/JointPositionController
      joint: FR_theta3
      pid: {p: 9, i: 0.03, d: 0.3055, i_clamp_min:  -1000, i_clamp_max: 1000}

  # RR Controllers ------------------------------------------------------------ 
  RR_theta1:
      type: effort_controllers/JointPositionController
      joint: RR_theta1
      pid: {p: 9, i: 0.03, d: 0.3055, i_clamp_min:  -1000, i_clamp_max: 1000}
        
  RR_theta2:
      type: effort_controllers/JointPositionController
      joint: RR_theta2
      pid: {p: 9, i: 0.03, d: 0.3055, i_clamp_min:  -1000, i_clamp_max: 1000}
        
  RR_theta3:
      type: effort_controllers/JointPositionController
      joint: RR_theta3
      pid: {p: 9, i: 0, d: 0.3055, i_clamp_min:  -1000, i_clamp_max: 1000}

  # RL Controllers ------------------------------------------------------------     
  RL_theta1:
      type: effort_controllers/JointPositionController
      joint: RL_theta1
      pid: {p: 9, i: 0.03, d: 0.3055, i_clamp_min:  -1000, i_clamp_max: 1000}
        
  RL_theta2:
      type: effort_controllers/JointPositionController
      joint: RL_theta2
      pid: {p: 9, i: 0.03, d: 0.3055, i_clamp_min:  -1000, i_clamp_max: 1000}
        
  RL_theta3:
      type: effort_controllers/JointPositionController
      joint: RL_theta3
      pid: {p: 9, i: 0.03, d: 0.3055, i_clamp_min:  -1000, i_clamp_max: 1000}
        
