ToolKnox/Quadruped-II/(commit log)

2026-04-30 Initial import from Quadruped_II Source.zip (Maker Portal)
    [FL1_obj.obj, FL_link1.STL, FL_link2.STL, FL_link3.STL, FL_link4.STL, FR1_obj.obj, FR_link1.STL, FR_link2.STL]
2026-06-06 docs: add Maker Portal readiness baseline
    Export BOM/docs baseline from Maker Portal software steward.
    [bom.csv]
2026-06-07 Update linked BOM from spreadsheet for Quadruped II
    [bom-source.xlsx, bom.csv]
2026-06-07 Publish PDF-only BOM for Quadruped II
    [bom-source.xlsx, bom.csv]
2026-07-08 docs: publish PDF-only BOM for Quadruped II
2026-07-08 docs: publish browser Bill of Material for Quadruped II
